IlIlIlIlIlIlIlIlIlIlIlIlIlIlI/Gepelemek1HF/kindlikdaniel_AHU27Z_BMGE_25261_HF1_dokumentacio.pdf

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

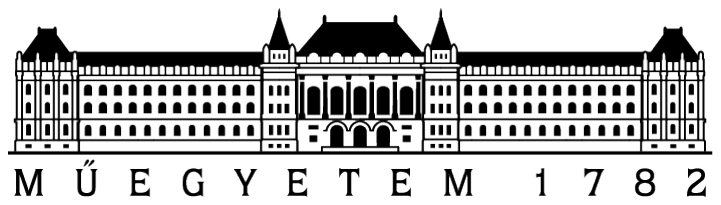
[picture p6: figure]
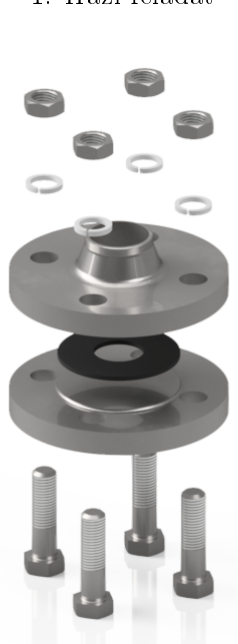
[picture p7: figure]
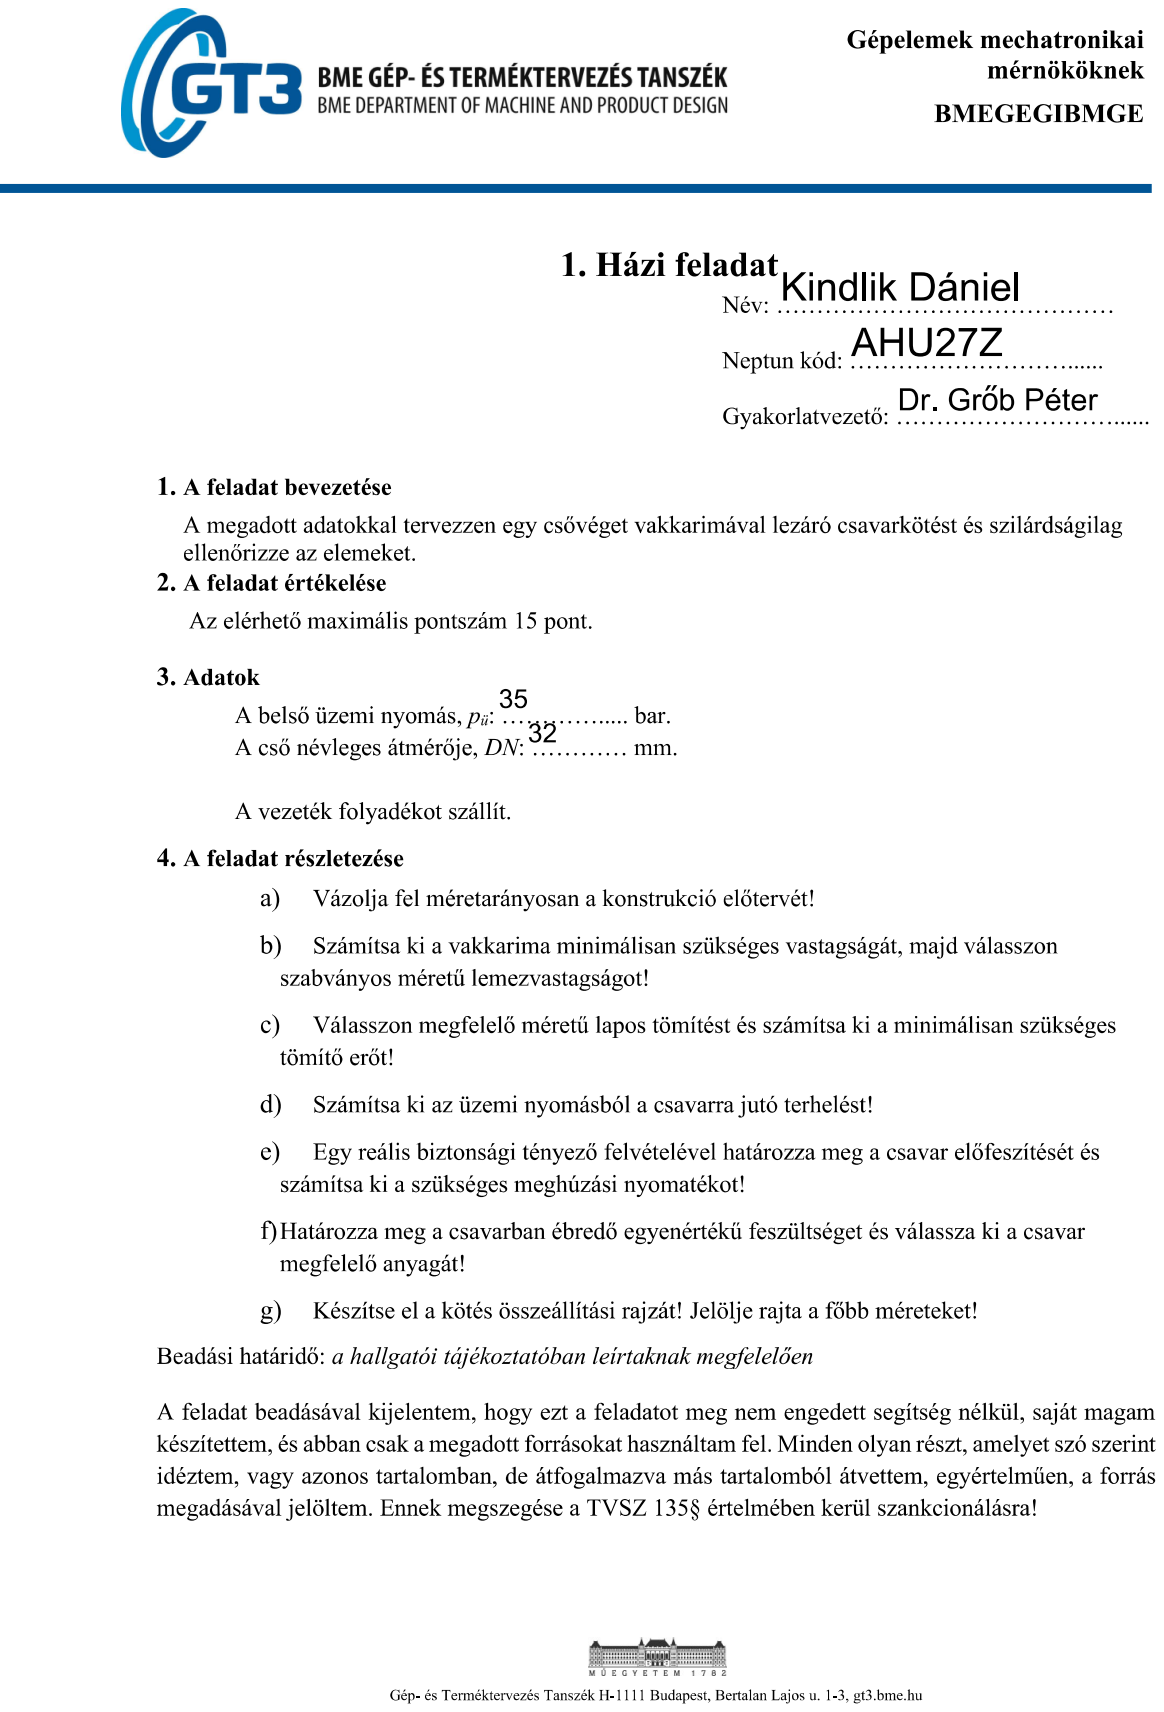
[picture p8: page 2]

### Tartalomjegyzék

1. El®tervek | 3
1.1. Karima szabvány választása | | 3
1.2. Vakkarima szabvány választása | | 4
1.3. Konstrukció el®terve | | 4
2. Vakkarima minimális vastagságának számítása, megfelel® lemezvastagság választása | 5
3. Megfelel® lapos tömítés választása, minimális tömítési er® számítása | 6
4. Csavarra jutó terhelés számítása | 7
5. Csavar el®feszítésének és szükséges meghúzási nyomaték számítása | 8
6. Csavar anyagának kiválasztása, benne ébred® egyenfeszültség kiválasztása | 10
7. Konstrukció összeállítási rajza | 11

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

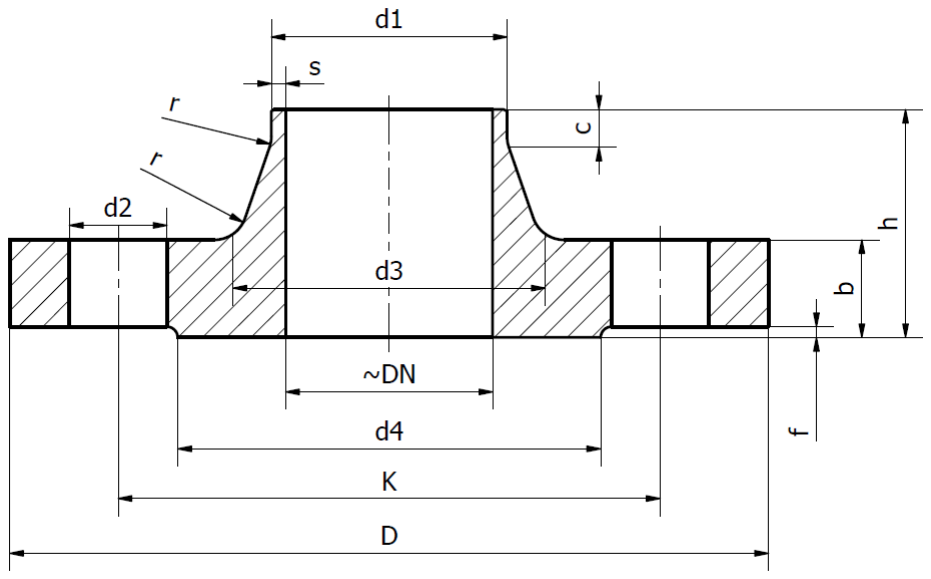
[picture p9: figure]

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

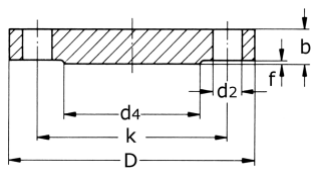
[picture p10: figure]

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

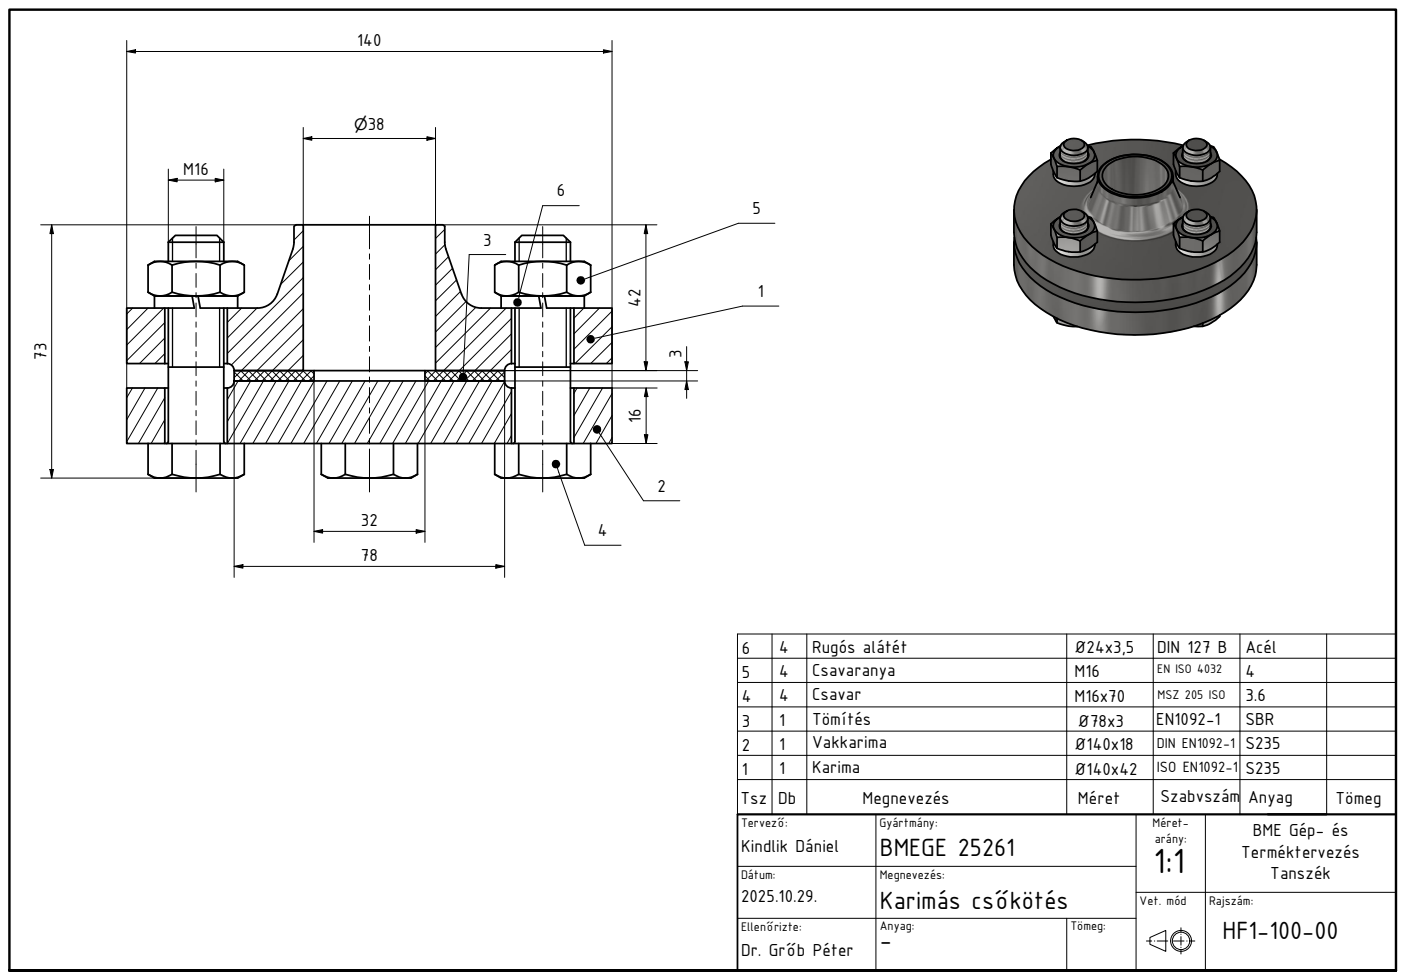
[picture p11: page 13]
Tervező:; Dátum:; Gyártmány:; Megnevezés:; Anyag:; Tömeg:; Méret- arány:; Vet. mód; Rajszám:; Kindlik Dániel; BMEGE 25261; Karimás csőkötés; Tsz; Megnevezés; Méret; Szabvszám; Anyag; Tömeg; Karima; ISO EN1092-1; Vakkarima; DIN EN1092-1; Rugós alátét; DIN 127 B; Acél

4 | Csavaranya | M 16 | EN ISO 4032 5 | 4
4 | 4 | Csavar | M16x70 | MSZ 205 ISO | 3.6
3 | 1 | Tömítés | Ø78x3 | EN1092-1 | SBR

BME Gép- és
Terméktervezés
Tanszék

Ellenőrizte:
Dr. Grőb Péter
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
