IlIlIlIlIlIlIlIlIlIlIlIlIlIlI/Gepelemek1HF/feladatlap.pdf

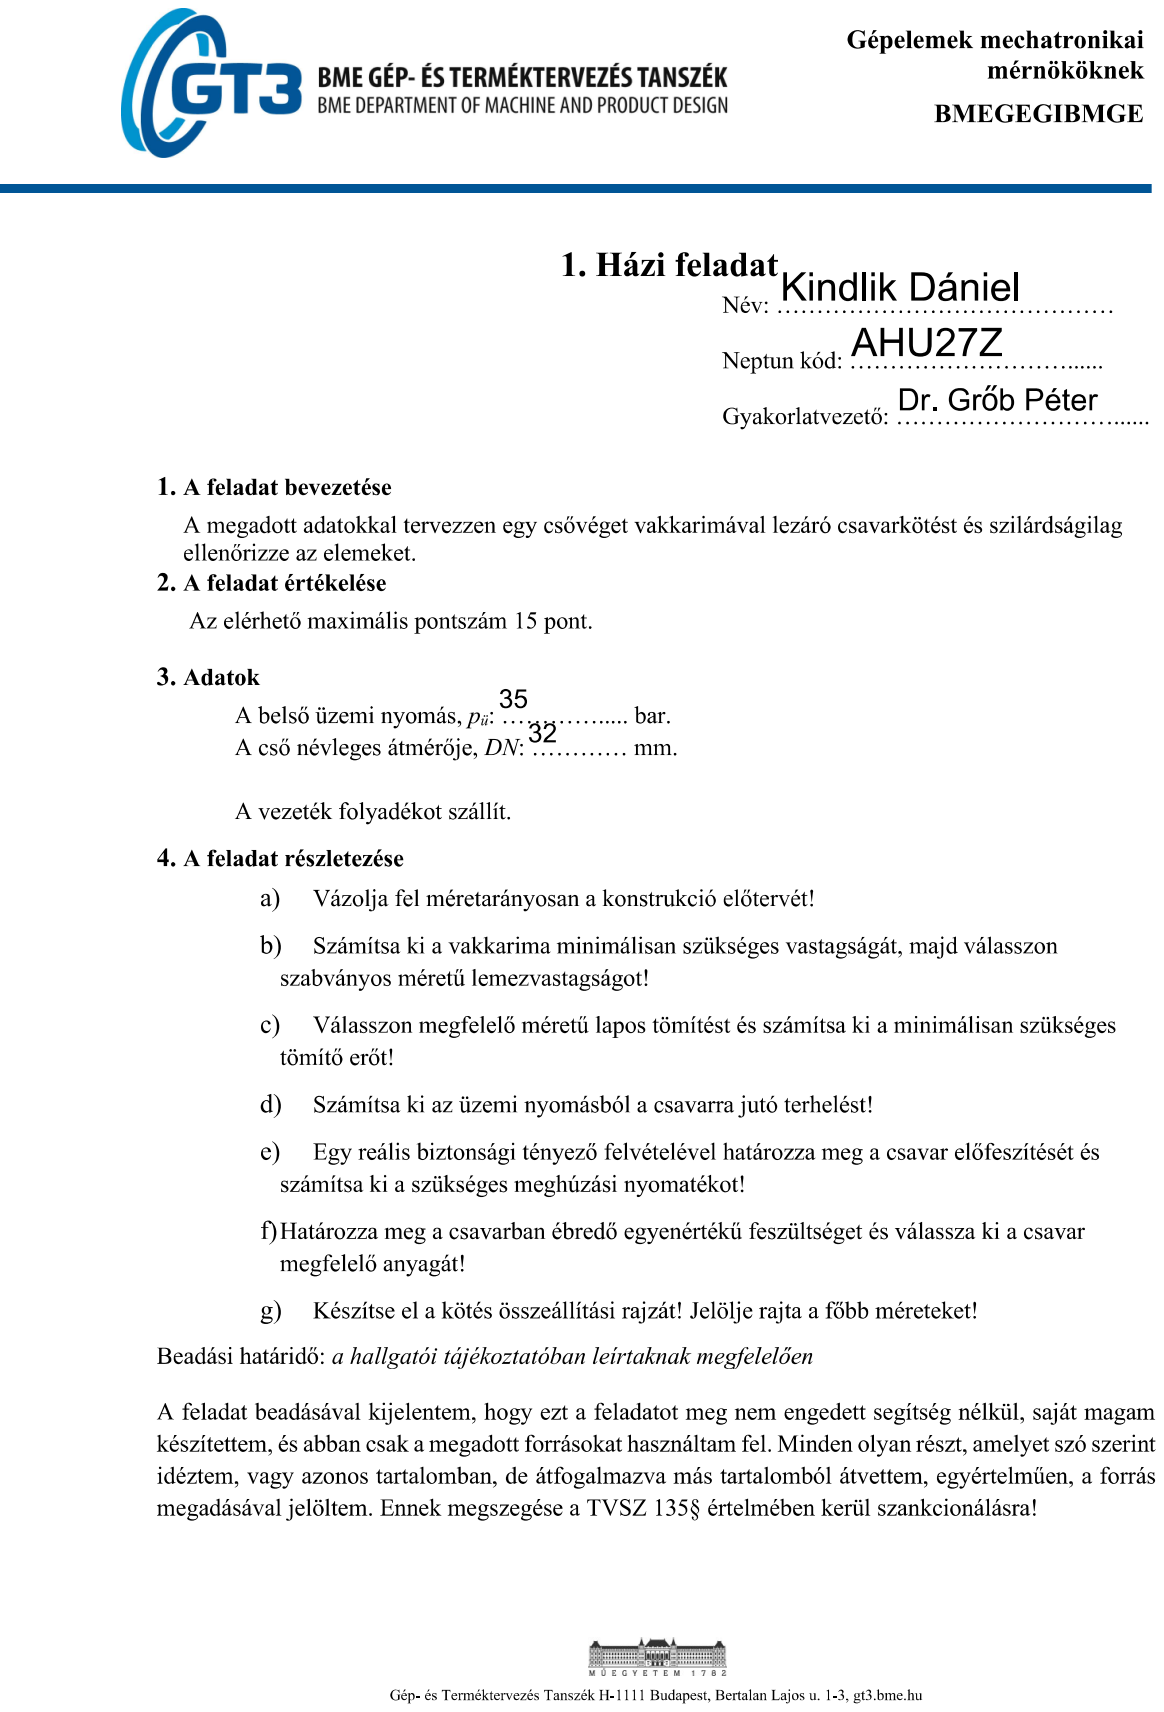
[picture p12: page 1]
