IlIlIlIlIlIlIlIlIlIlIlIlIlIlI/Gepelemek1HF/tomites_eloterv.png

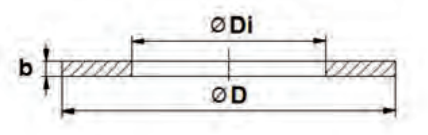
tomites_eloterv.png
