IlIlIlIlIlIlIlIlIlIlIlIlIlIlI/Gepelemek1HF/(list of files, cad)

Other CAD files:
Inventor/karima.dwg
Inventor/osszallitasifel2.dwg
Inventor/osszallitasifel.dwg
Inventor/OldVersions/osszallitasifel2.0001.dwg
Inventor/OldVersions/osszallitasifel.0022.dwg
Inventor/OldVersions/karima.0001.dwg
Inventor/OldVersions/alatet.0002.ipt
Inventor/OldVersions/csavar.0001.ipt
Inventor/OldVersions/csavar.0001_1.ipt
Inventor/OldVersions/csavaranya.0002.ipt
Inventor/OldVersions/karima.0001.ipt
Inventor/OldVersions/osszeallitas.0001.iam
Inventor/OldVersions/tomites.0001.ipt
Inventor/OldVersions/vakkarima.0002.ipt
Inventor/alatet.ipt
Inventor/csavar.ipt
Inventor/csavaranya.ipt
Inventor/karima.ipt
Inventor/osszeallitas.iam
Inventor/osszeallitas.ipn
Inventor/tomites.ipt
Inventor/vakkarima.ipt
