IlIlIlIlIlIlIlIlIlIlIlIlIlIlI/Gepelemek1HF/karima.pdf

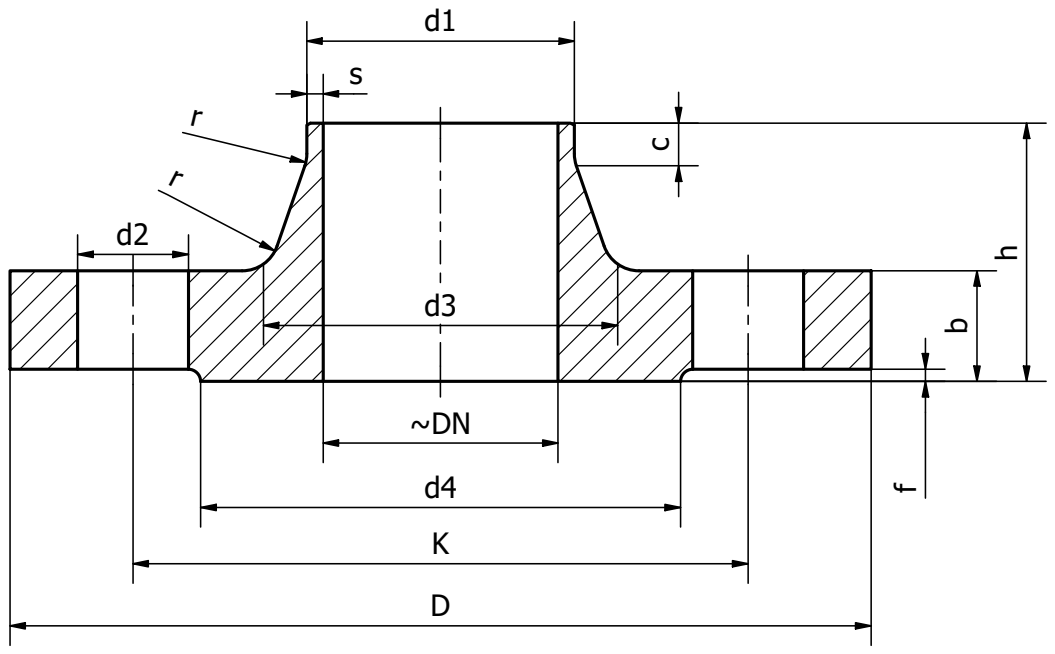
[picture p14: page 1]
User; Designed by; Checked by; Approved by; Date
