IlIlIlIlIlIlIlIlIlIlIlIlIlIlI/Gepelemek1HF/osszallitasifel2.pdf

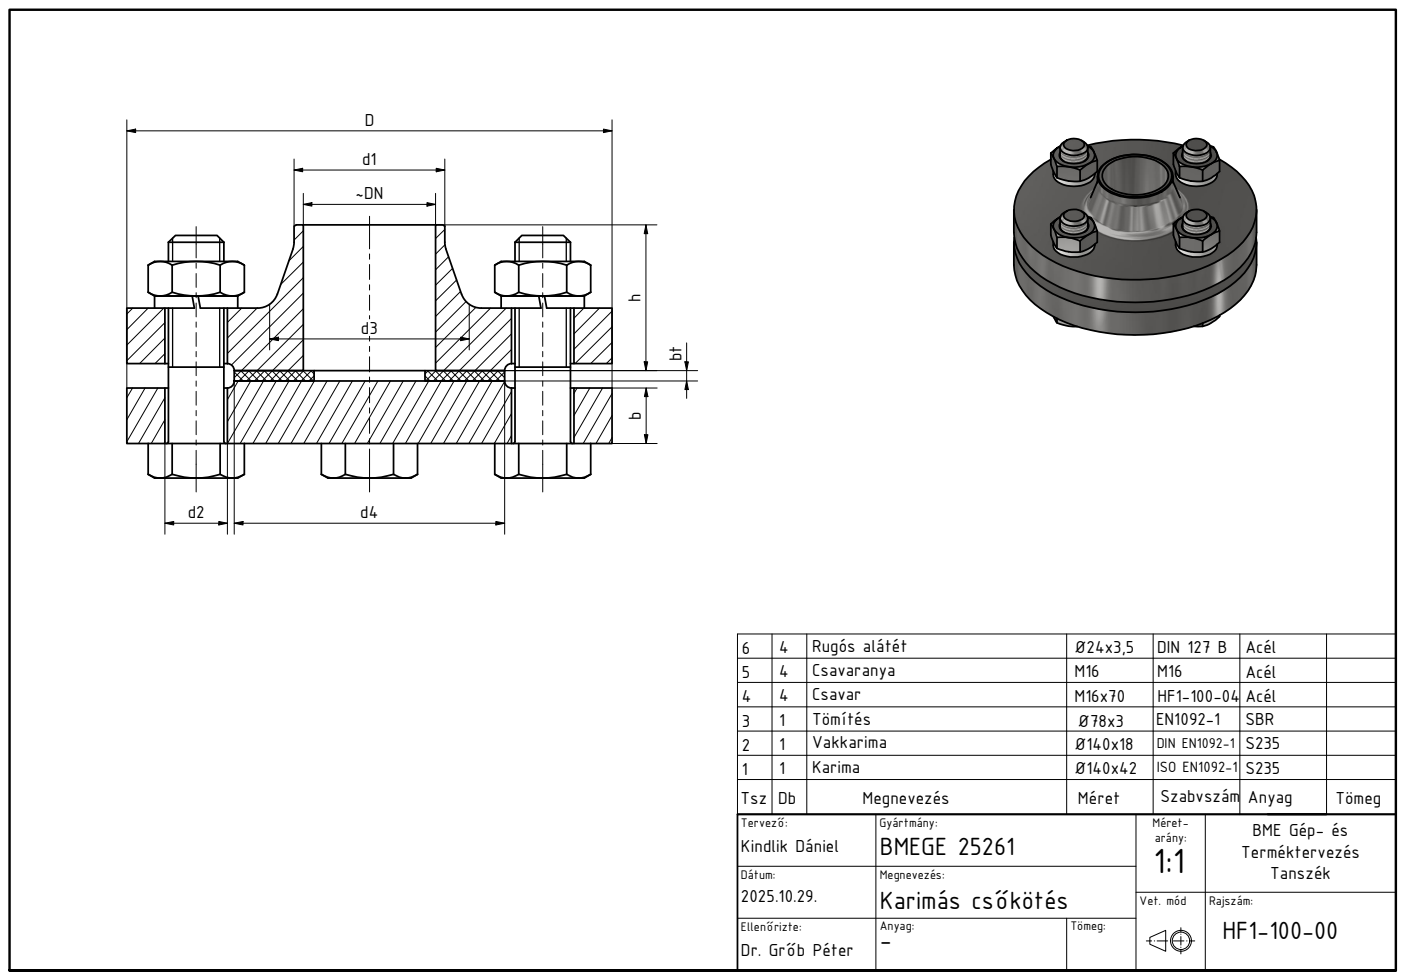
[picture p15: page 1]

6 | 4 | Rugós alátét | Ø24x3,5 | DIN 127 B | Acél
5 | 4 | Csavaranya | M16 | M16 | Acél
4 | 4 | Csavar | M16x70 | HF1-100-04 | Acél
3 | 1 | Tömítés | Ø78x3 | EN1092-1 | SBR
2 | 1 | Vakkarima | Ø140x18 | DIN EN1092-1 | S235
1 | 1 | Karima | Ø140x42 | ISO EN1092-1 | S235
Tsz | Db | Megnevezés | Méret | Szabvszám | Anyag | Tömeg

Tervező: Kindlik Dániel | Gyártmány: BMEGE 25261 | Méret-arány: 1:1 | BME Gép- és Terméktervezés Tanszék

Dátum: 2025.10.29. | Megnevezés: Karimás csőkötés

Vet. mód | Rajszám: HF1-100-00

Ellenőrizte: Dr. Grőb Péter | Anyag: - | Tömeg:
